LouisVenhoff/ChaynsLEDGateway/chayns/ChaynsLEDGatewayApp/chayns-led-gateway/README.md

<div align="center">
    <h1>chayns-led-gateway</h1>
    <p>Controll App for the Chayns Neopixel LED Controller</p>
    <a href="https://github.com/TobitSoftware/chayns-toolkit">
        
    </a>
</div>

---

## Get Started

To get started with working on the project first you have to install its dependencies:

```bash
npm install
```

Then you will have the following commands available:

### `npm run dev`

This starts the project with a local server for development. Typically this will be on
[`http://localhost:1234/`](http://localhost:1234/), but this
[can be adjusted](https://github.com/TobitSoftware/chayns-toolkit#development-options).

### `npm run build`

This builds your project for production.

> If you want to analyze your bundle size you can do so by passing the `-a` flag to this command.

### `npm run lint`

Checks your project for errors and code quality.

### `npm run format`

Automatically formats all of the source code in your project.

---

This project is based on [`chayns-toolkit`](https://github.com/TobitSoftware/chayns-toolkit). If you
encounter any issues with the toolchain and the commands, please
[open an issue](https://github.com/TobitSoftware/chayns-toolkit/issues/new).
