LouisVenhoff/ChaynsLEDGateway/CentralControllerCaseCap.stl

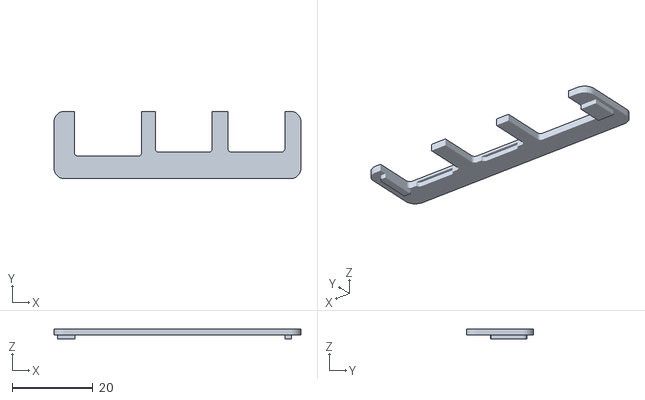
[picture p1: CAD file, 2026-08-31]
CentralControllerCaseCap.stl
61.2 x 16.7 x 2.60
