LouisVenhoff/ChaynsLEDGateway/hardware/.stl

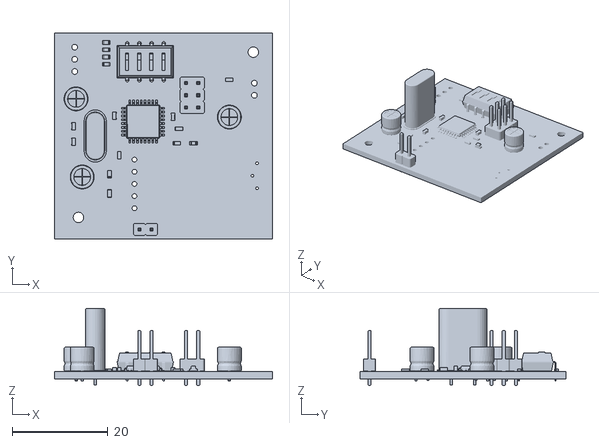
[picture p2: CAD file, 2026-08-15]
hardware/.stl
45.5 x 43.0 x 16.1
