LouisVenhoff/ChaynsLEDGateway/hardware/GehäuseV2/ChaynsLEDCaseV2.stl

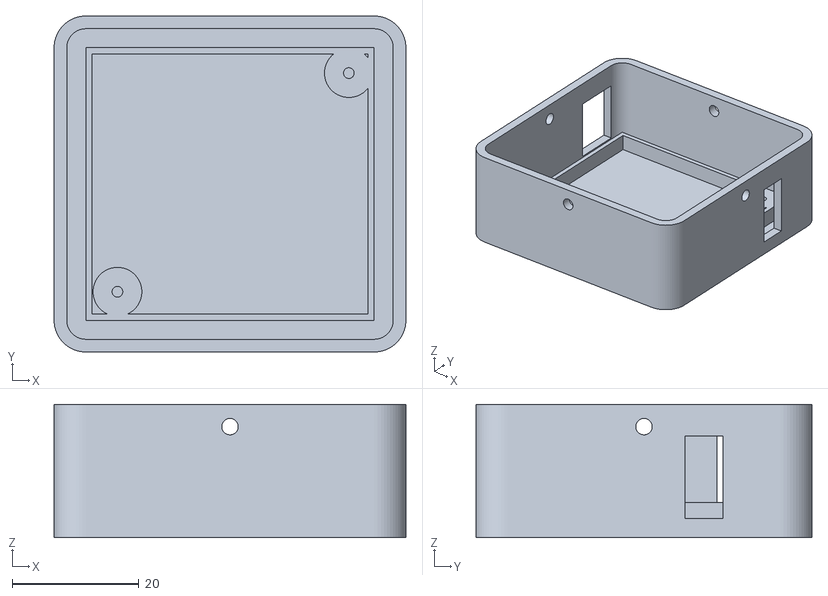
[picture p3: CAD file, 2026-08-22]
hardware/GehäuseV2/ChaynsLEDCaseV2.stl
55.5 x 53.0 x 21.0
