LouisVenhoff/ChaynsLEDGateway/CentralControllerCase.stl

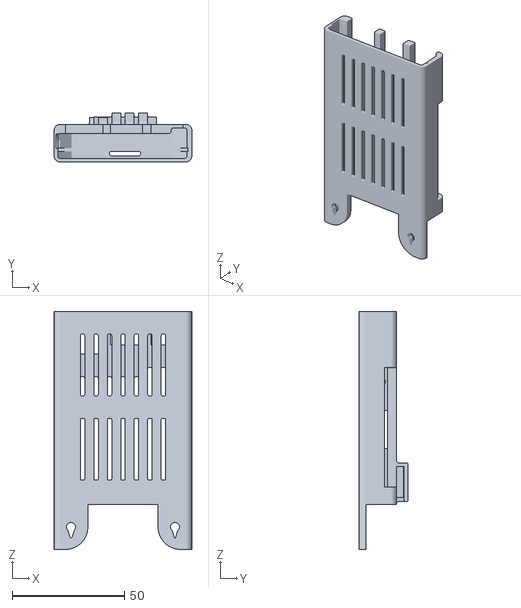
[picture p4: CAD file, 2026-08-31]
CentralControllerCase.stl
61.2 x 21.7 x 105.8
