LouisVenhoff/ChaynsLEDGateway/hardware/GehäuseV2/ChaynsLEDCaseCapV2.stl

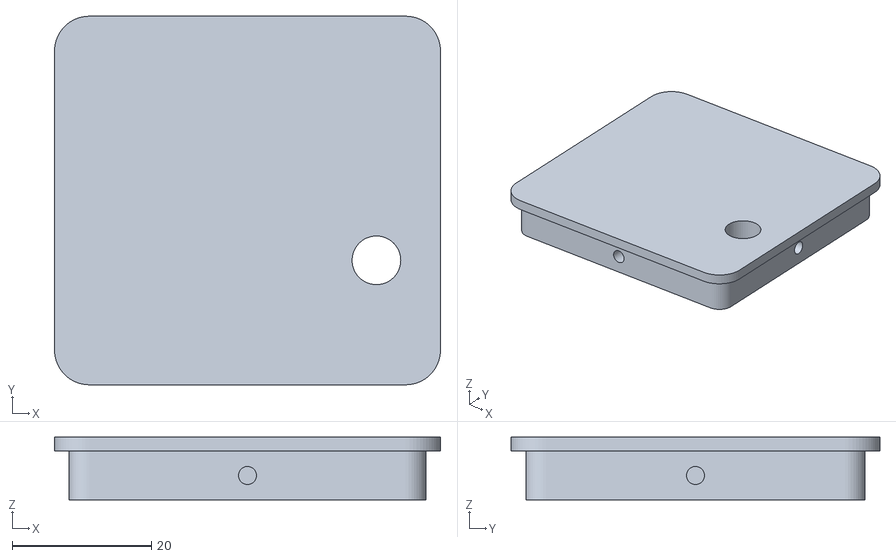
[picture p5: CAD file, 2026-08-22]
hardware/GehäuseV2/ChaynsLEDCaseCapV2.stl
55.5 x 53.0 x 9.00
