LouisVenhoff/ChaynsLEDGateway/hardware/GehäuseV1/ChaynsLEDCaseBaseV1.stl

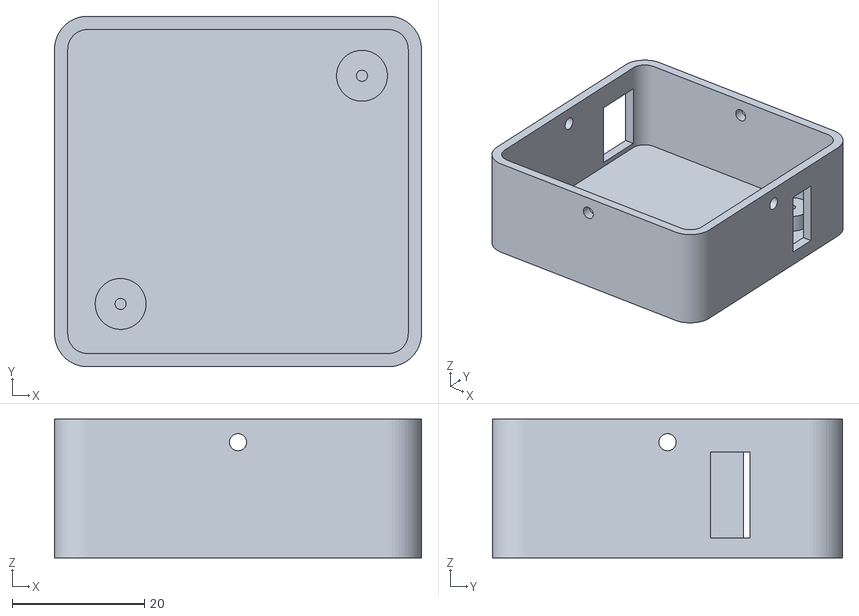
[picture p6: CAD file, 2026-08-15, an earlier design]
hardware/GehäuseV1/ChaynsLEDCaseBaseV1.stl
55.5 x 53.0 x 21.0
