LouisVenhoff/ChaynsLEDGateway/(list of files, cad)

Other CAD files:
hardware/board.step
hardware/GehäuseV1/ChaynsLEDCaseCapV1.stl
hardware/board.3mf
