LouisVenhoff/ChaynsLEDGateway/hardware/CaynsLEDGateway.kicad_pcb

## KiCad design hardware/CaynsLEDGateway.kicad_pcb (2026-08-15)

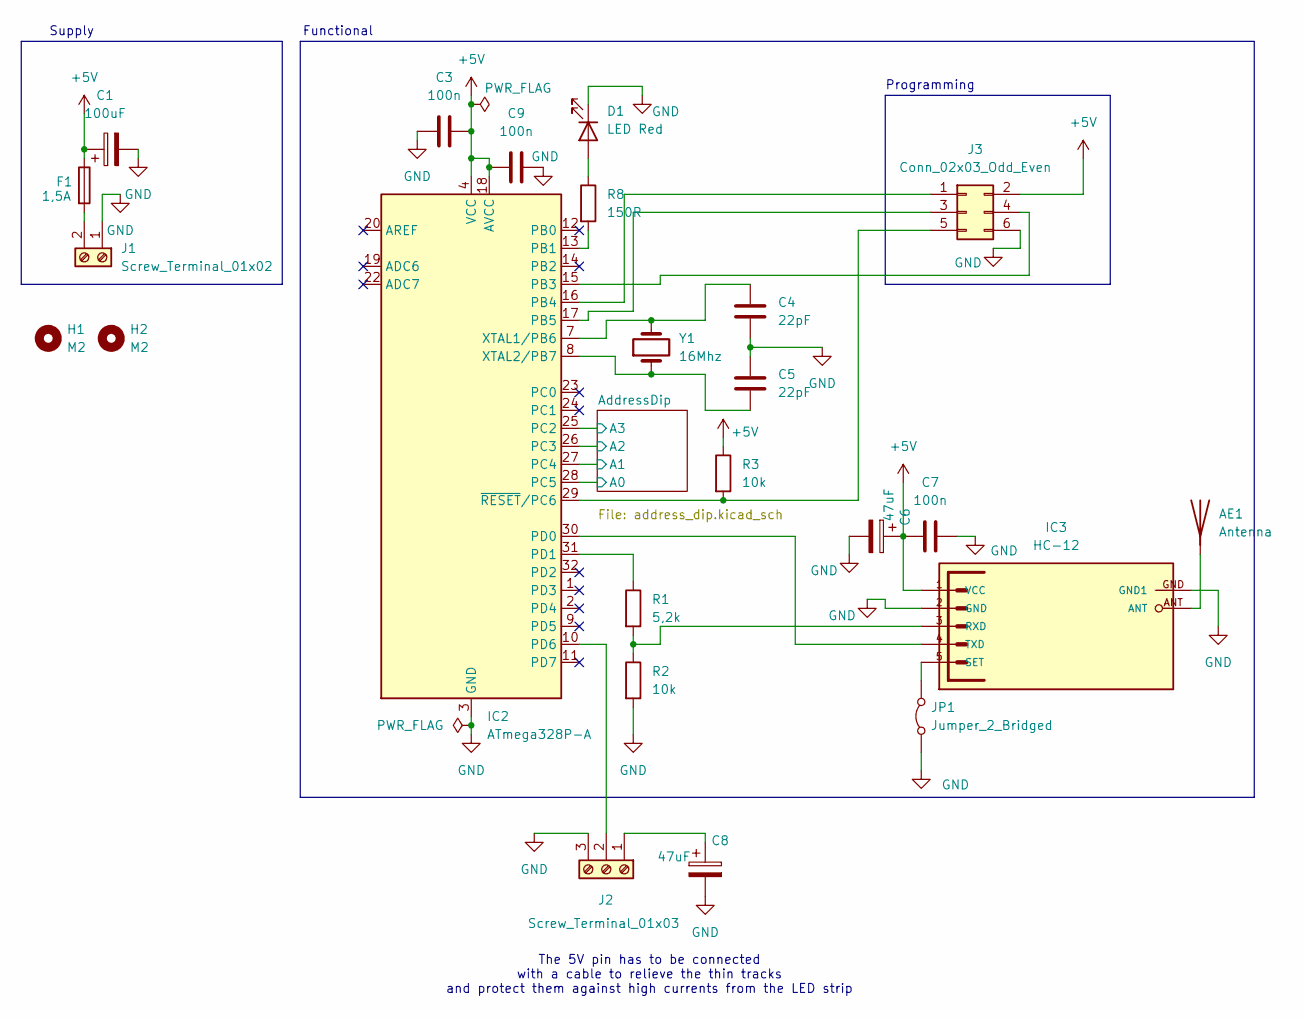
[picture p7: schematic CaynsLEDGateway.kicad_sch]

Parts:
AE1: Antenna
C1: 100uF; CP_Radial_D5.0mm_P2.50mm
C3, C7, C9: 100n; C_0603_1608Metric
C4, C5: 22pF; C_0603_1608Metric
C6, C8: 47uF; CP_Radial_D5.0mm_P2.50mm
D1: LED Red; LED_0603_1608Metric
F1: 1,5A; Fuse_0603_1608Metric
H1, H2: M2; MountingHole_2.2mm_M2
IC2: ATmega328P-A; TQFP-32_7x7mm_P0.8mm
IC3: HC-12; MA05-1
J1: Screw_Terminal_01x02; TerminalBlock_Xinya_XY308-2.54-2P_1x02_P2.54mm_Horizontal
J2: Screw_Terminal_01x03; TerminalBlock_Xinya_XY308-2.54-3P_1x03_P2.54mm_Horizontal
J3: Conn_02x03_Odd_Even; PinHeader_2x03_P2.54mm_Vertical
JP1: Jumper_2_Bridged; PinHeader_1x02_P2.54mm_Vertical
R1: 5,2k; R_0603_1608Metric
R2, R3: 10k; R_0603_1608Metric
R8: 150R; R_0603_1608Metric
Y1: 16Mhz; Crystal_HC18-U_Vertical

Connections:
+5V: C1.1, C3.2, C6.1, C7.1, C9.2, F1.1, IC2.4 (VCC), IC2.6 (VCC), IC2.18 (AVCC), IC3.1 (VCC), J3.2, R3.1; also elsewhere on the board
/AddressDip/A0: IC2.28 (PC5); also elsewhere on the board
/AddressDip/A1: IC2.27 (PC4); also elsewhere on the board
/AddressDip/A2: IC2.26 (PC3); also elsewhere on the board
/AddressDip/A3: IC2.25 (PC2); also elsewhere on the board
GND: C1.2, C3.1, C4.1, C5.2, C6.2, C7.2, C8.2, C9.1, D1.1 (K), IC2.3 (GND), IC2.5 (GND), IC2.21 (GND), IC3.2 (GND), IC3.GND (GND1), IC3.GND1, J1.1, J2.3, J3.6, JP1.1 (A), R2.2; also elsewhere on the board
unnamed: AE1.1, IC3.ANT
unnamed: D1.2 (A), R8.1
unnamed: IC2.13 (PB1), R8.2
unnamed: IC2.15 (PB3), J3.4
unnamed: IC2.16 (PB4), J3.1
unnamed: IC2.17 (PB5), J3.3
unnamed: IC2.30 (PD0), IC3.4 (TXD)
unnamed: IC2.31 (PD1), R1.1
unnamed: IC2.10 (PD6), J2.2
unnamed: C4.2, IC2.7 (XTAL1/PB6), Y1.2
unnamed: C5.1, IC2.8 (XTAL2/PB7), Y1.1
unnamed: IC2.29 (~RESET/PC6), J3.5, R3.2
unnamed: IC3.3 (RXD), R1.2, R2.1
unnamed: IC3.5 (SET), JP1.2 (B)
unnamed: F1.2, J1.2
unnamed: C8.1, J2.1

Notes on the sheet:
The 5V pin has to be connected with a cable to relieve the thin tracks and protect them against high currents from the LED strip
Programming
Functional
Supply

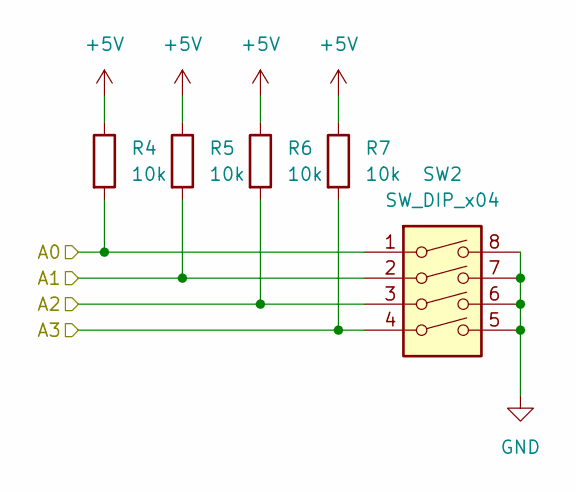
[picture p8: schematic address_dip.kicad_sch]

Parts:
R4, R5, R6, R7: 10k; R_0603_1608Metric
SW2: SW_DIP_x04; SW_DIP_SPSTx04_Slide_6.7x11.72mm_W7.62mm_P2.54mm_LowProfile

Connections:
+5V: R4.1, R5.1, R6.1, R7.1; also elsewhere on the board
/AddressDip/A0: R4.2, SW2.1; also elsewhere on the board
/AddressDip/A1: R5.2, SW2.2; also elsewhere on the board
/AddressDip/A2: R6.2, SW2.3; also elsewhere on the board
/AddressDip/A3: R7.2, SW2.4; also elsewhere on the board
GND: SW2.5, SW2.6, SW2.7, SW2.8; also elsewhere on the board

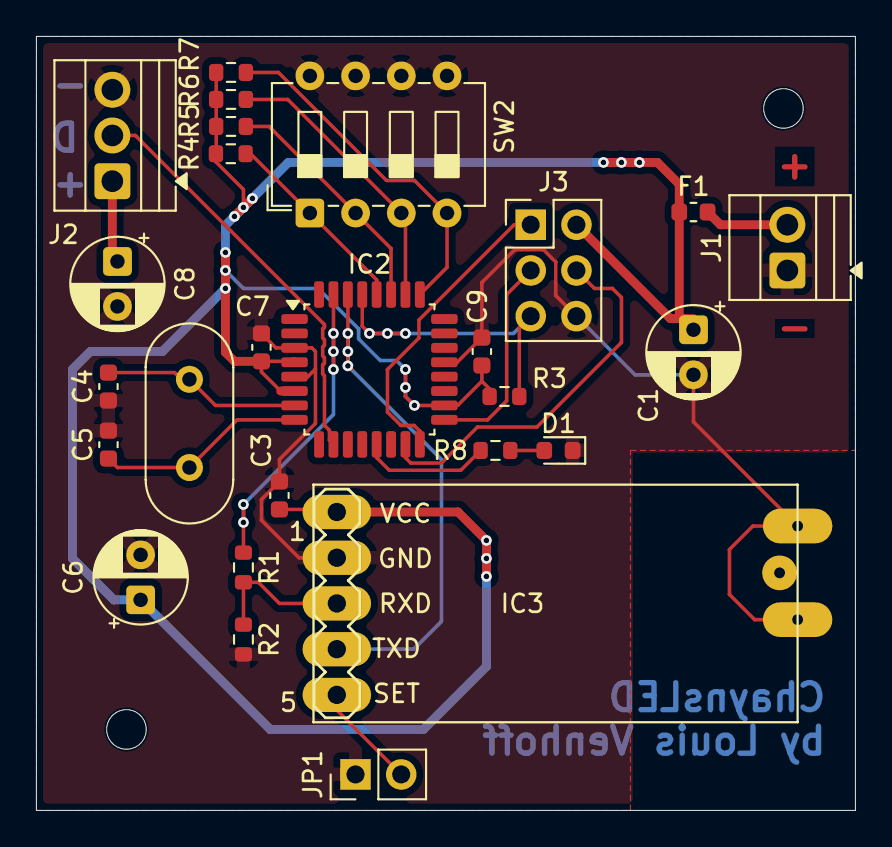
[picture p9: board CaynsLEDGateway.kicad_pcb from above]

Board: 2 copper layers, 45.5 x 43.0 mm, 28 parts (0 on the bottom side), 21 nets.
