LouisVenhoff/ChaynsLEDGateway/mqtt-radio-gateway/src/mqtt.cpp

#include "mqtt.h"

using json = nlohmann::json;


extern const string SERVER_ADDRESS("mqtt://mqtt.chayns.io:1883");
extern const string CLIENT_ID("99825-09414-vQWMKzXq");
const string PWD("r2VjIYeNnBXmtPT3qp2x");
const string TOPIC("chayns-led");

class callback : public virtual mqtt::callback {
    
    int fd = -1;

    public:void setFd(int fileDescriptor){
        fd = fileDescriptor;
    }

    void message_arrived(mqtt::const_message_ptr msg) override {
        //std::cout << "Message received:" << msg->get_payload_str() << std::endl;

        if(fd == -1){
            std::cout << "UART not connected!" << std::endl;
        }

        json data = json::parse(msg->get_payload_str());

        std::cout << data["address"] << std::endl;
        
        string addressString = data["address"];
        u_int8_t address = stoi(addressString);
        
        bool enabled = data["enabled"];



        auto colorArray = data["color"];
        u_int8_t animation = data["animation"];
        int brightness = static_cast<int>(data["brightness"]);
        u_int8_t commandType = data["commandType"];
        


        cmd command;
        command.address = address;
        command.enabled = enabled;
        command.colorR = colorArray[0].get<uint8_t>();
        command.colorG = colorArray[1].get<uint8_t>();
        command.colorB = colorArray[2].get<uint8_t>();
        command.animation = animation;
        command.brightness = brightness;
        command.commandType = commandType;

        vector<uint8_t> byteData =  generateProtocolBytes(command);

        sendSerial(fd, byteData);
    }
};


int connectToBroker(mqtt::async_client& mqtt_client){
    
    int fd = -1;

    beginSerial(&fd);
    
    static callback cb;

    cb.setFd(fd);

    mqtt_client.set_callback(cb);

    mqtt::connect_options conOpts;

    conOpts.set_keep_alive_interval(20);
    conOpts.set_clean_session(true);
    conOpts.set_user_name(CLIENT_ID);
    conOpts.set_password(PWD);

    try{
        mqtt_client.connect(conOpts) -> wait();

        cout << "Connected to Chayns MQTT Broker" << endl;
        return 0;
    }
    catch(const mqtt::exception& exc){
        cout << "Connection failed!" << exc.what() << endl;
        return -1;
    }
}

int subscribeTopic(mqtt::async_client& mqtt_client){

    try{
        mqtt_client.subscribe(TOPIC, 1)->wait();
    }
    catch(mqtt::exception& exc){
        cout << "Connection failed!" << exc.what() << endl;
        return -1;
    }

    std::cout << "Subscribed to" << TOPIC << std::endl;
    return 0;
}
