LouisVenhoff/ChaynsLEDGateway/hardware/Chayns_LED_Test_Script/Chayns_LED_Test_Script.ino

/*
  Blink

  Turns an LED on for one second, then off for one second, repeatedly.

  Most Arduinos have an on-board LED you can control. On the UNO, MEGA and ZERO
  it is attached to digital pin 13, on MKR1000 on pin 6. LED_BUILTIN is set to
  the correct LED pin independent of which board is used.
  If you want to know what pin the on-board LED is connected to on your Arduino
  model, check the Technical Specs of your board at:
  https://docs.arduino.cc/hardware/

  modified 8 May 2014
  by Scott Fitzgerald
  modified 2 Sep 2016
  by Arturo Guadalupi
  modified 8 Sep 2016
  by Colby Newman

  This example code is in the public domain.

  https://docs.arduino.cc/built-in-examples/basics/Blink/
*/


int LED_CHAYNS_LED_BOARD = 9;

// the setup function runs once when you press reset or power the board
void setup() {
  // initialize digital pin LED_BUILTIN as an output.
  pinMode(LED_CHAYNS_LED_BOARD, OUTPUT);
}

// the loop function runs over and over again forever
void loop() {
  digitalWrite(LED_CHAYNS_LED_BOARD, HIGH);  // change state of the LED by setting the pin to the HIGH voltage level
  delay(1000);                      // wait for a second
  digitalWrite(LED_CHAYNS_LED_BOARD, LOW);   // change state of the LED by setting the pin to the LOW voltage level
  delay(500);
  
  
  for(int i = 0; i < 2; i++){
    digitalWrite(LED_CHAYNS_LED_BOARD, HIGH);
    delay(50);
    digitalWrite(LED_CHAYNS_LED_BOARD, LOW);
    delay(50);
  }
  
  delay(2000);                      // wait for a second
}
