LouisVenhoff/ChaynsLEDGateway/(commit log)

2026-08-15 Added rooms and devices
2026-08-15 configured devices
2026-08-15 Show app only when light is switched on
2026-08-20 Added central controller
    [CentralControllerCase.stl, CentralControllerCaseCap.stl]
2026-08-22 Created folder for hardware
    [.stl, CaynsLEDGateway.kicad_pcb, CaynsLEDGateway.kicad_sch, ChaynsLEDCaseBaseV1.stl, ChaynsLEDCaseCapV1.stl, address_dip.kicad_sch, board.3mf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]
2026-08-22 Added gerber files to hardware folder
    [CaynsLEDGateway-B_Cu.gbr, CaynsLEDGateway-B_Mask.gbr, CaynsLEDGateway-B_Paste.gbr, CaynsLEDGateway-B_Silkscreen.gbr, CaynsLEDGateway-Edge_Cuts.gbr, CaynsLEDGateway-F_Cu.gbr, CaynsLEDGateway-F_Mask.gbr, CaynsLEDGateway-F_Paste.gbr]
2026-08-22 Added new case version stl files
    [ChaynsLEDCaseCapV2.stl, ChaynsLEDCaseV2.stl]
2026-08-25 Established connection to chayns test broker
    [main.cpp, mqtt.cpp]
2026-08-28 Stringify and print state to console
2026-09-05 Fixed bug while generating bytes for protocol
    [protocolParser.cpp]
2026-09-05 Send values via UART
2026-09-10 Readded raspberry uart interface
2026-09-13 Show Address with LED Blink Codes
